Gernreich/panpipes/step/panpipes-tubes-hex-zigzag.step

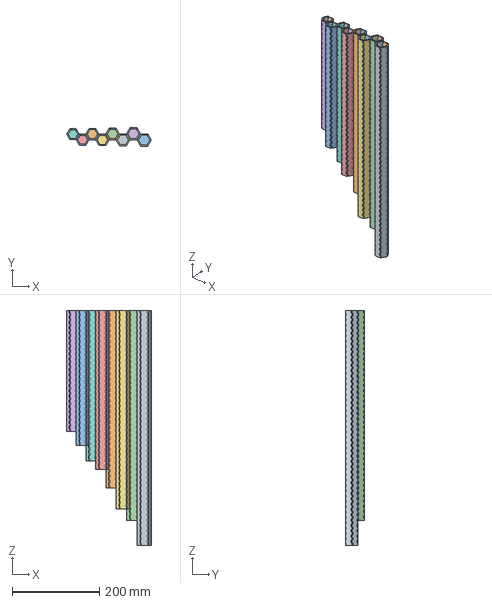
[picture p1: CAD file, 2026-11-08]
step/panpipes-tubes-hex-zigzag.step
194.3 x 42.5 x 538.8 mm
