Gernreich/panpipes/step/panpipes-notch-edge.step

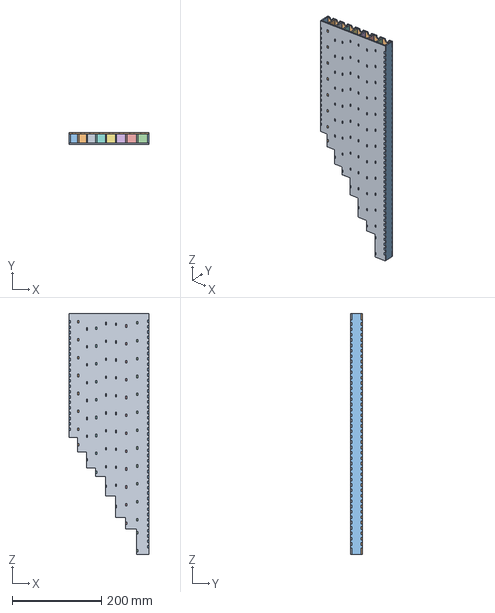
[picture p2: CAD file, 2026-11-08]
step/panpipes-notch-edge.step
179.0 x 26.0 x 538.8 mm
