Gernreich/panpipes/step/panpipes-tubes-octagon-row.step

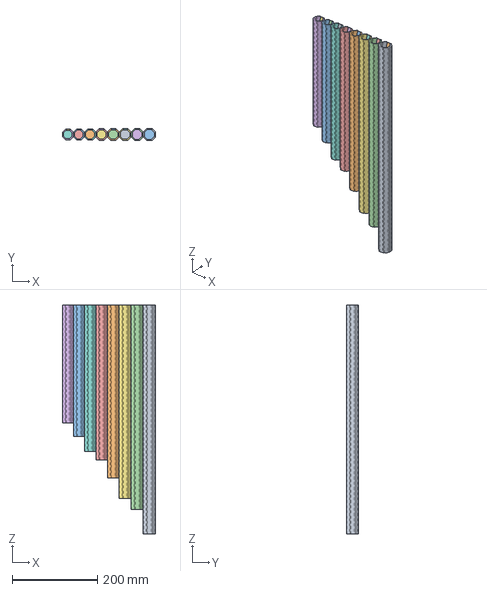
[picture p3: CAD file, 2026-11-08]
step/panpipes-tubes-octagon-row.step
219.1 x 29.0 x 538.8 mm
