Gernreich/panpipes/step/panpipes-tubes-octagon-two-rows.step

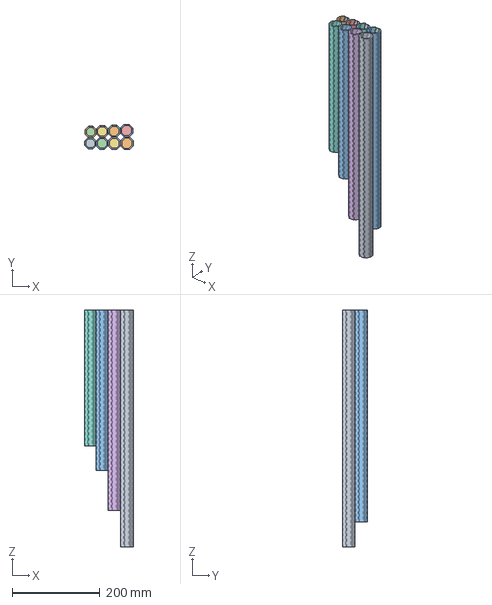
[picture p4: CAD file, 2026-11-08]
step/panpipes-tubes-octagon-two-rows.step
110.5 x 57.6 x 538.8 mm
