Gernreich/panpipes/step/panpipes-tubes-hex-row.step

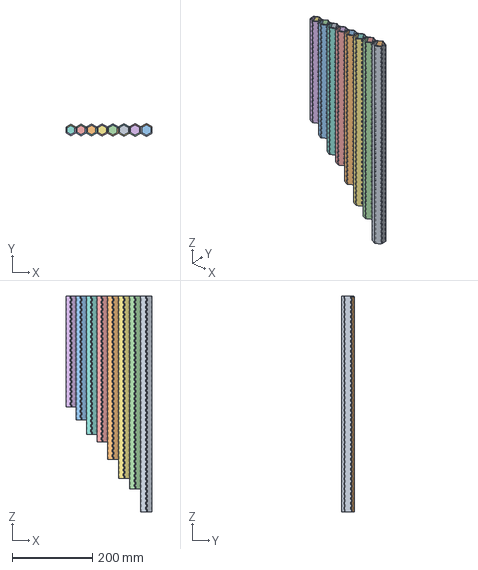
[picture p5: CAD file, 2026-11-08]
step/panpipes-tubes-hex-row.step
215.4 x 33.0 x 538.8 mm
