Gernreich/panpipes/(list of files, cad)

Other CAD files:
step/panpipes-strip-edge.step
step/panpipes-chamfer-edge.step
step/panpipes-plain-edge.step
