Gernreich/panpipes/(commit log)

2026-10-19 Low panpipes, E3 to E4: eight closed pipes between two plates, four blowing edges
    panpipes.py draws a raft of eight closed rectangular pipes in E natural
    minor, tuned by press-fit plugs pushed up from below, the bore narrowing
    from 22 to 16mm across a constant 20mm depth. --edge= picks the blowing
    edge: chamfer (a bevel sanded to an engraved line, the default), plain,
    notch (a U cut over each pipe) or strip (1.5mm stock glued on). Every
    build has its cut files, previews and a view in turn.html.
2026-10-19 Bevel the notches as a quena's: a line engraved 2mm round each one
    The notch build now engraves a line on the back plate's outside, 2mm out
    from every notch, and the README says to file a 45 degree bevel down to it,
    leaving a 1mm edge. A check holds each line within its pipe and clear of
    the joints.
2026-10-19 Tube sets: the same pipes as octagonal or hexagonal tubes, glued side to side
    tube_panpipes.py builds each pipe as its own finger-jointed tube, the
    octagonal flute's polyhedron joint, and glues the tubes face to face:
    octagon-row, hex-zigzag (two rows, the back one raised 15mm for the lip,
    --raise=) and hex-row. Bore areas match the raft's, so the air columns and
    plugs do too. Edges chamfer, plain and notch (no notch on hex-row's corner).
    Checks include coplanar glue faces and no two tubes overlapping.
2026-10-19 Panpipes review: tube assembly, spacer side, bevel per tube, notch ranges
    Thirteen-lens review fixes. The README told the builder the one strip with
    a blue line is a tube's front, but two (three on hex-row) carry lines and
    the strips come in three finger patterns; step 1 now says how to sort and
    ring them. The zigzag spacer goes under the FRONT row (the back row's rims
    stand past it). The back faces are not in line, so bevel each tube alone.
    Notch sizes are ranges; 'the one glued joint in any build' was stale;
    pointer to Before you cut; tube engrave order. tube_panpipes.py refuses a
    one-pipe set instead of crashing, and says 'the rims level' at --raise=0.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
2026-10-19 Tube sets: octagon-two-rows, the siku layout; zigzag rims level by default
    octagon-two-rows: two rows of octagons, each glued flat to flat in a line,
    the back row glued behind the front, each back pipe behind the note below
    it, rims level as a siku's are. Back-row plug lines move to the back face,
    since the front is glued; front-row bevels are sanded across the joint (no
    line, no notch). centres() now returns the glued pairs, and the glue check
    measures the shared flat face of each pair; GLUE_MIN named, 5mm.
    hex-zigzag: RAISE defaults to 0, level rims as tradition has them;
    --raise= keeps the taller back row as an option.
2026-10-21 Review: hex-row is the least conventional of four tube sets, not three
2026-10-22 Link back to all projects at the top of the README and the page
    The rest of the build files now points at lasermademusic.html, where the
    instruments moved when the root page became a directory.
2026-10-23 3D views: fitted to their frames, and framed bare on the page
2026-11-07 Call lasermade-tools' Rust programs, not its Python scripts
    The tools became Rust on 2026-11-07: target/release/<name> in lasermade-tools
    (cargo build --release there) replaces python3 <name>.py, in commands,
    manifests and prose. Pages rebuilt; no generated file changes otherwise.
2026-11-07 3D pages through lasermade-tools' turn3d program; turn3d.py is gone
    The pages are byte for byte the same.
2026-11-07 The generators are Rust: panpipes.rs, tube_panpipes.rs, every cut file and page byte for byte the same
2026-11-08 Cargo.lock: four-hole-ocarinas now builds on square-flute
2026-11-08 Cargo.lock: bore-tmm now depends on lasermade-tools and roxmltree
2026-11-08 STEP files of the 3D view, for a CAD program
    One file per design in step/, one solid body per part, written from the
    3D page by lasermade-tools step-export and checked by .repro. Every file
    opens in SolidCraft with every body closed and no warnings.
    [panpipes-chamfer-edge.step, panpipes-notch-edge.step, panpipes-plain-edge.step, panpipes-strip-edge.step, panpipes-tubes-hex-row.step, panpipes-tubes-hex-zigzag.step, panpipes-tubes-octagon-row.step, panpipes-tubes-octagon-two-rows.step]
2026-11-08 Every build as a parametric SolidCraft design; the STEP files written by SolidCraft
    The raft's four edges and the tube sets' ten builds: each pipe's note sets
    its length and its plug, and the walls, the staircase, the tabs and slots,
    or the tubes' cells along every edge, follow; ply, the bores and the edges'
    sizes are parameters too. Checked body by body against the generators' parts.
    [panpipes-chamfer-edge.step, panpipes-notch-edge.step, panpipes-plain-edge.step, panpipes-strip-edge.step, panpipes-tubes-hex-row.step, panpipes-tubes-hex-zigzag.step, panpipes-tubes-octagon-row.step, panpipes-tubes-octagon-two-rows.step]
